Arsenico22/Sigmoid_Accelerator_IP-CORE/Presentazione.pdf

Dipartimento di Ingegneria Informatica, Modellistica, Elettronica e Sistemistica

Corso di Laurea Magistrale in Ingegneria Elettronica

Design e caratterizzazione di IP-Core su FPGA

per funzioni di attivazione in modelli di

Intelligenza Artificiale

ANNO ACCADEMICO 2025/2026

Relatrice:

Prof.ssa Stefania Perri

Candidato:

Danilo Antonio Tarantino
Matr. 247705

## Introduzione 1/16

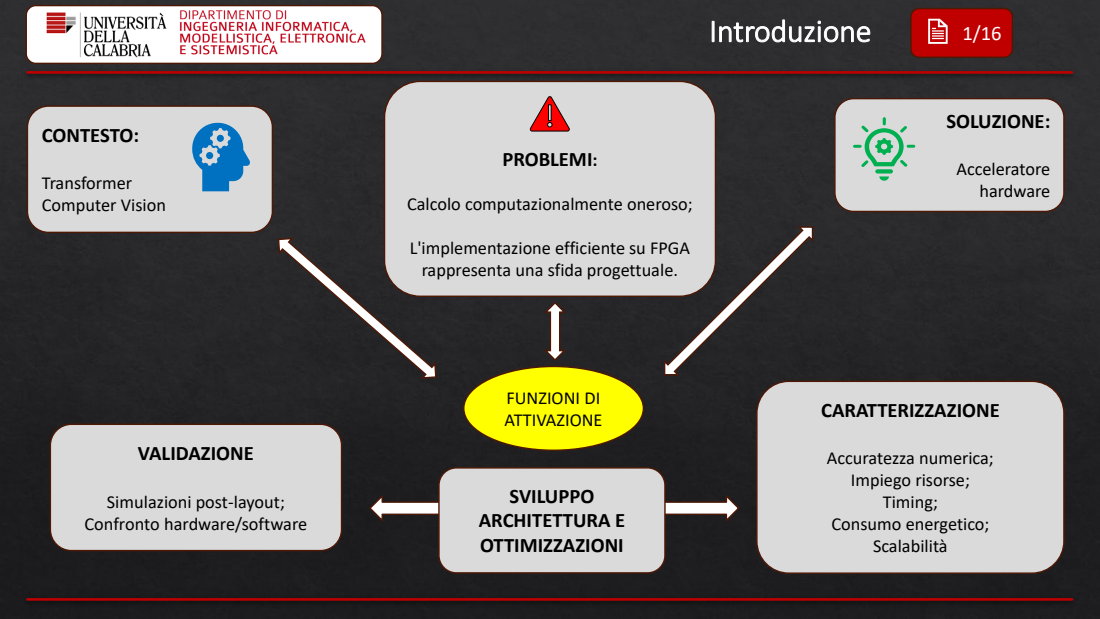
[picture p63: page 2]
SOLUZIONE:; Acceleratore hardware; FUNZIONI DI ATTIVAZIONE; CONTESTO:; Transformer Computer Vision; PROBLEMI:; SVILUPPO ARCHITETTURA E OTTIMIZZAZIONI; VALIDAZIONE; CARATTERIZZAZIONE; Accuratezza numerica; Impiego risorse; Timing; Consumo energetico; Scalabilità

Calcolo computazionalmente oneroso;

L'implementazione efficiente su FPGA
rappresenta una sfida progettuale.

Simulazioni post-layout;
Confronto hardware/software

## Contesto

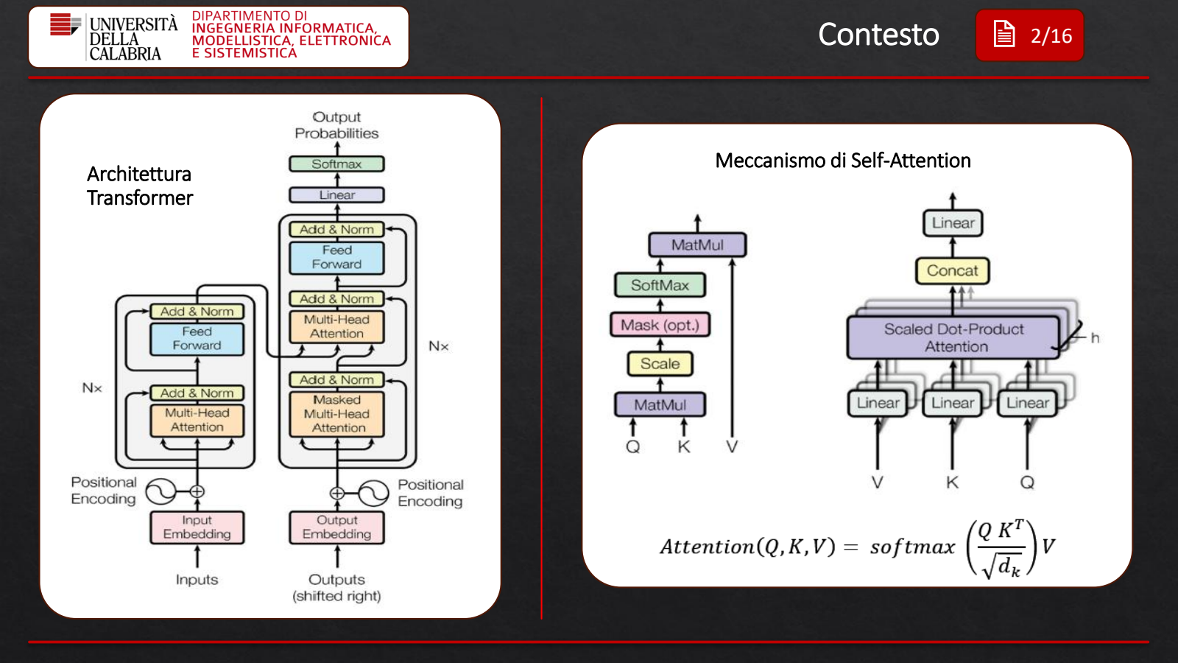
[picture p64: page 3]

2/16

Meccanismo di Self-Attention Architettura Transformer

## Funzioni di Attivazione 3/16

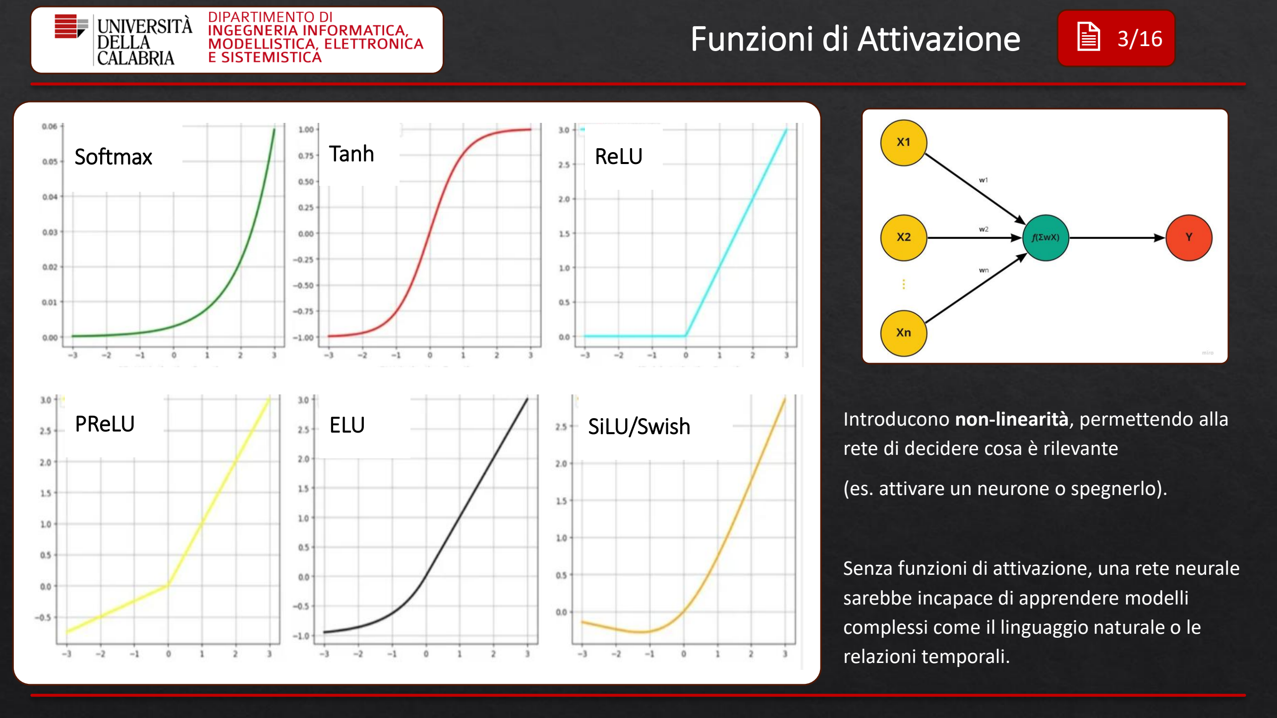
[picture p65: page 4]

Introducono non-linearità, permettendo alla rete di decidere cosa è rilevante

(es. attivare un neurone o spegnerlo).

Senza funzioni di attivazione, una rete neurale sarebbe incapace di apprendere modelli complessi come il linguaggio naturale o le relazioni temporali.

Softmax | Tanh | ReLU
PReLU | ELU | SiLU/Swish

## Caso studio: Funzione Sigmoide 4/16

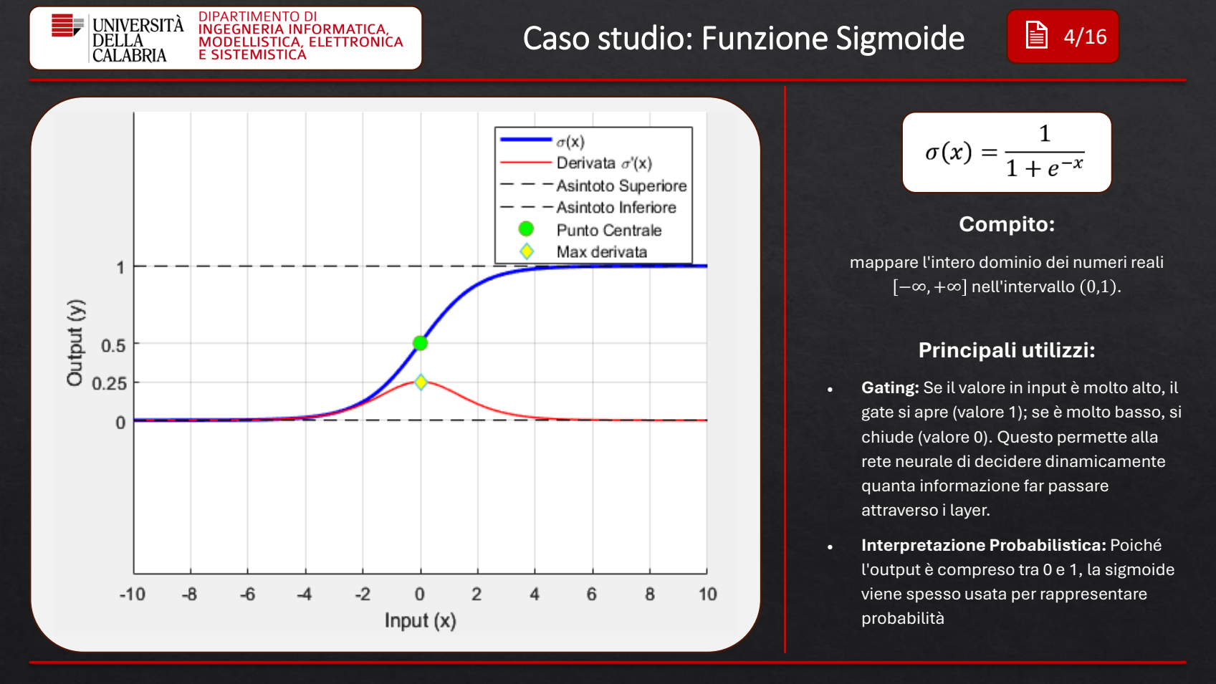
[picture p66: page 5]

### Compito:

mappare l'intero dominio dei numeri reali −∞, +∞ nell'intervallo 0,1 .

### Principali utilizzi:

- Gating: Se il valore in input è molto alto, il gate si apre (valore 1); se è molto basso, si chiude (valore 0). Questo permette alla rete neurale di decidere dinamicamente quanta informazione far passare attraverso i layer.
- Interpretazione Probabilistica: Poiché l'output è compreso tra 0 e 1, la sigmoide viene spesso usata per rappresentare probabilità

## Approccio utilizzato 5/16

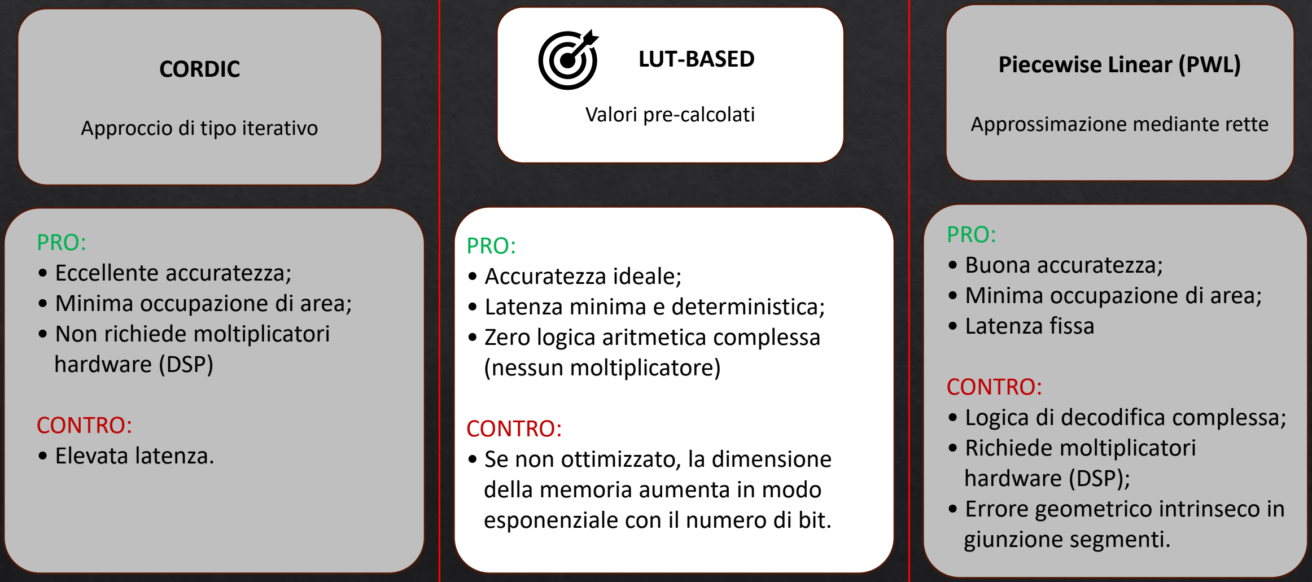
[picture p67: figure]
Piecewise Linear (PWL); Approssimazione mediante rette; LUT-BASED; Valori pre-calcolati; CORDIC; Approccio di tipo iterativo; PRO: • Eccellente accuratezza; • Minima occupazione di area; • Non richiede moltiplicatori hardware (DSP); CONTRO: • Elevata latenza.; PRO: • Accuratezza ideale; • Latenza minima e deterministica; • Zero logica aritmetica complessa (nessun moltiplicatore); CONTRO: • Se non ottimizzato, la dimensione della memoria aumenta in modo esponenziale con il numero di bit.; PRO: • Buona accuratezza; • Minima occupazione di area; • Latenza fissa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

6/16

## Flusso di lavoro

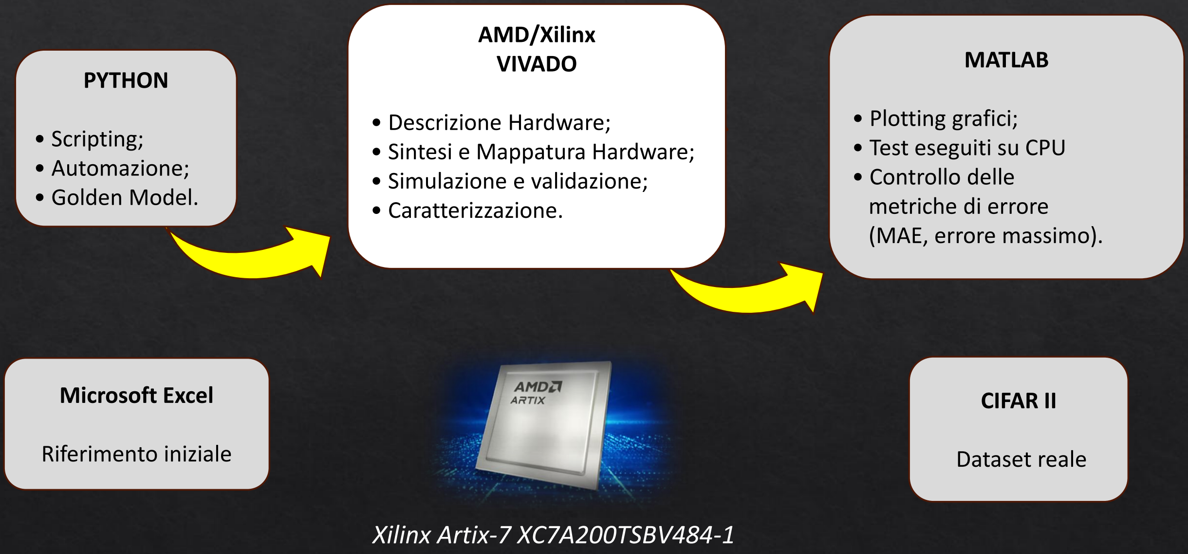
[picture p68: figure]
Xilinx Artix-7 XC7A200TSBV484-1; AMD/Xilinx VIVADO; • Descrizione Hardware; • Sintesi e Mappatura Hardware; • Simulazione e validazione; • Caratterizzazione.; MATLAB; • Plotting grafici; • Test eseguiti su CPU • Controllo delle metriche di errore (MAE, errore massimo).; PYTHON; • Scripting; • Automazione; • Golden Model.; Microsoft Excel; Riferimento iniziale; CIFAR II; Dataset reale

Baseline (V1) | Intermedia (V2) | Avanzata (V3) Architetture

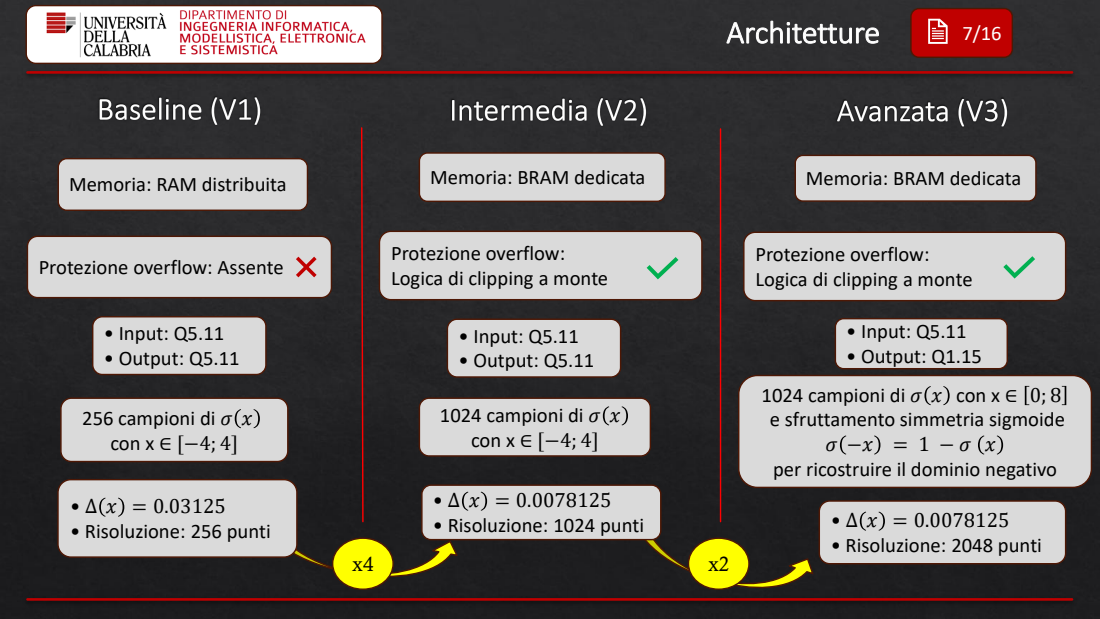
[picture p69: page 8]
256 campioni di σ x con x ∈ [−4; 4]; 1024 campioni di σ x con x ∈ [−4; 4]; 1024 campioni di σ x con x ∈; • Input: Q5.11 • Output: Q5.11; • Input: Q5.11 • Output: Q1.15; Memoria: RAM distribuita; Memoria: BRAM dedicata; • Δ x = 0.03125 • Risoluzione: 256 punti; • Risoluzione: 1024 punti; • Risoluzione: 2048 punti

Protezione overflow:
Logica di clipping a monte

Protezione overflow: Assente

e sfruttamento simmetria sigmoide
per ricostruire il dominio negativo

## Test e validazione

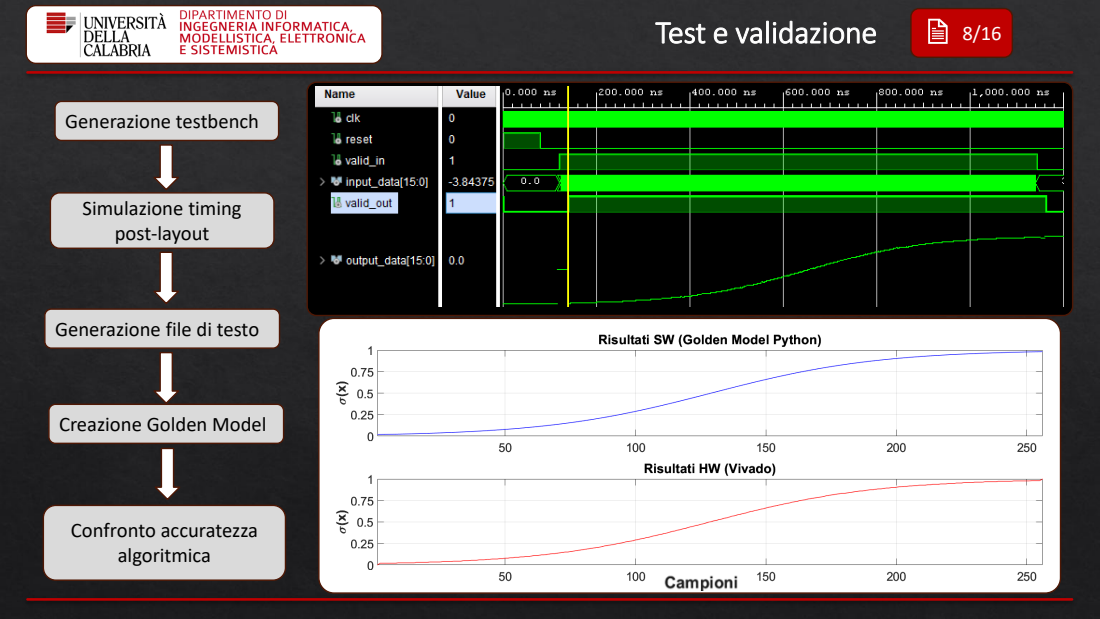
[picture p70: page 9]
Generazione testbench; Simulazione timing post-layout; Confronto accuratezza algoritmica

Generazione file di testo

Creazione Golden Model

## Confronto hardware vs software

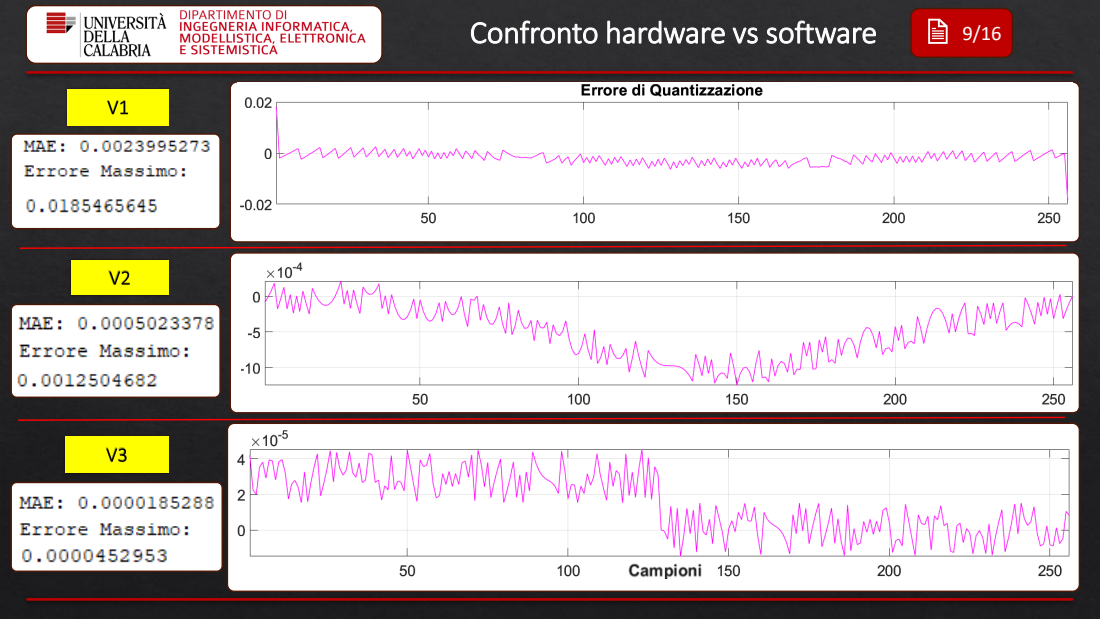
[picture p71: page 10]

## Report di utilizzo risorse

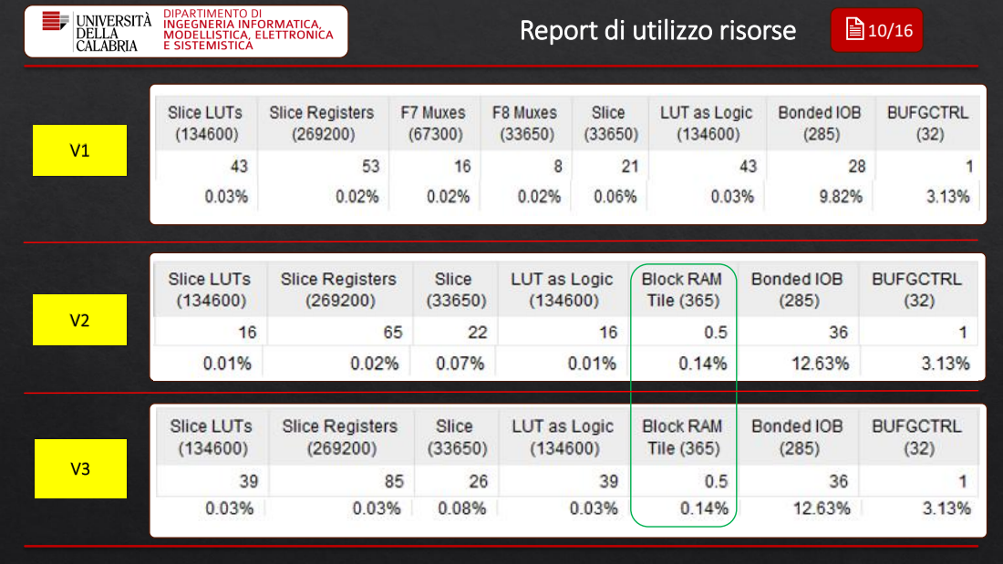
[picture p72: page 11]

## Report di timing

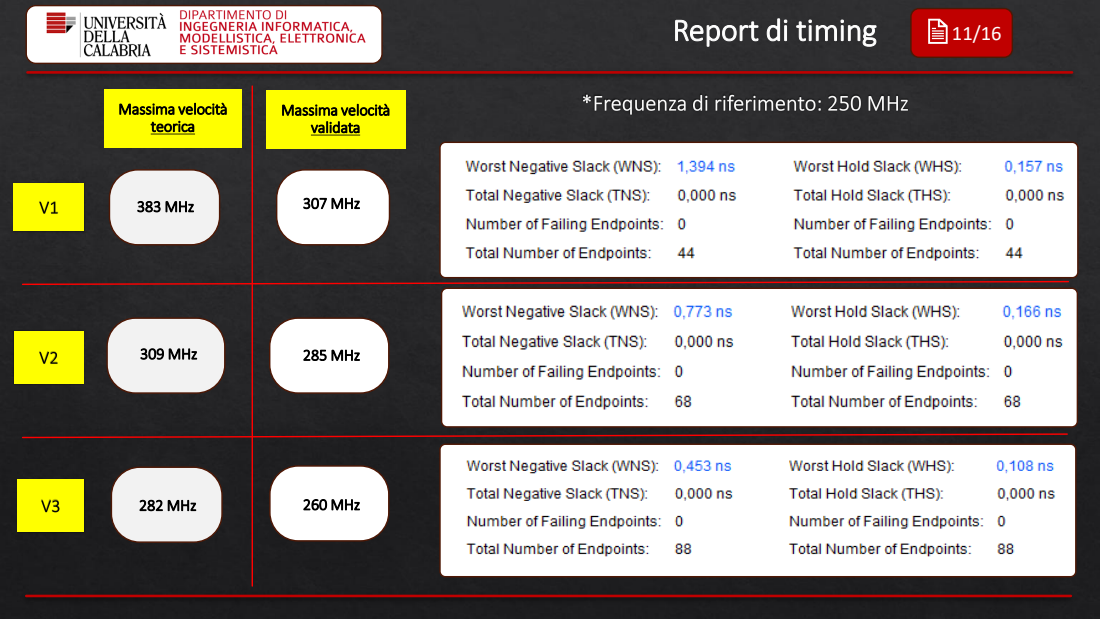
[picture p73: page 12]
Massima velocità teorica; 285 MHz; Massima velocità validata; 307 MHz; 260 MHz; 383 MHz; 309 MHz; 282 MHz

*Frequenza di riferimento: 250 MHz

## Report di potenza 12/16

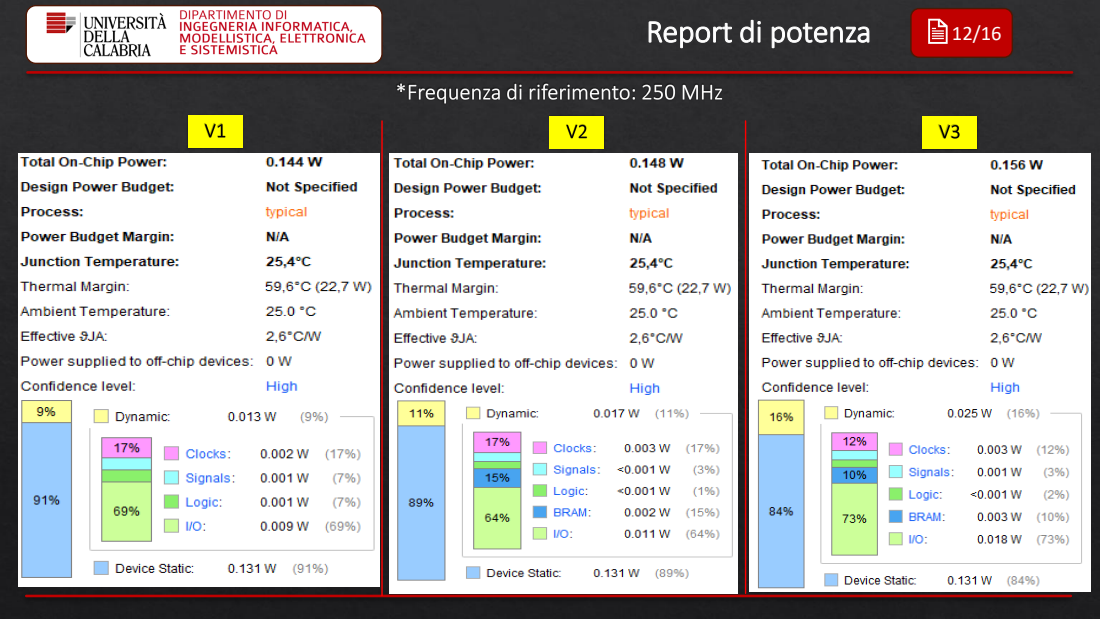
[picture p74: page 13]

*Frequenza di riferimento: 250 MHz

## Parallelismo 13/16

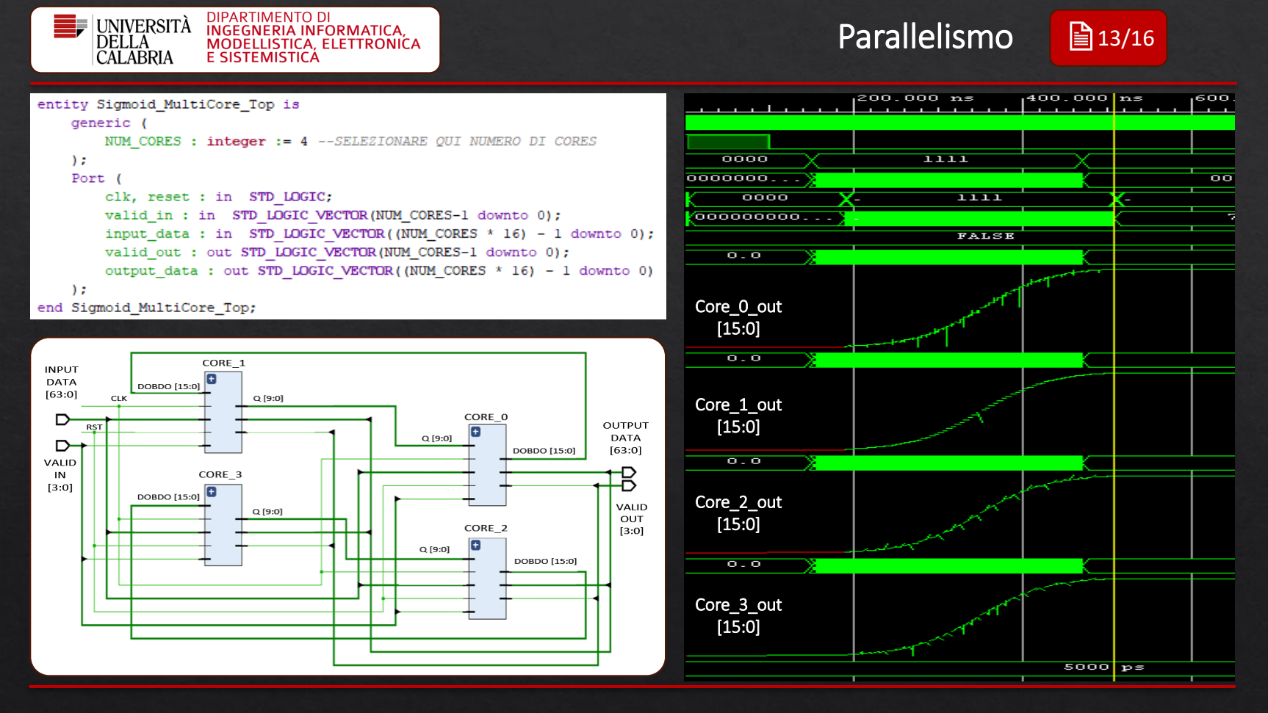
[picture p75: page 14]

Core_0_out
[15:0]

Core_1_out
[15:0]

Core_2_out
[15:0]

Core_3_out
[15:0]

## Scalabilità (Analisi OOC) 14/16

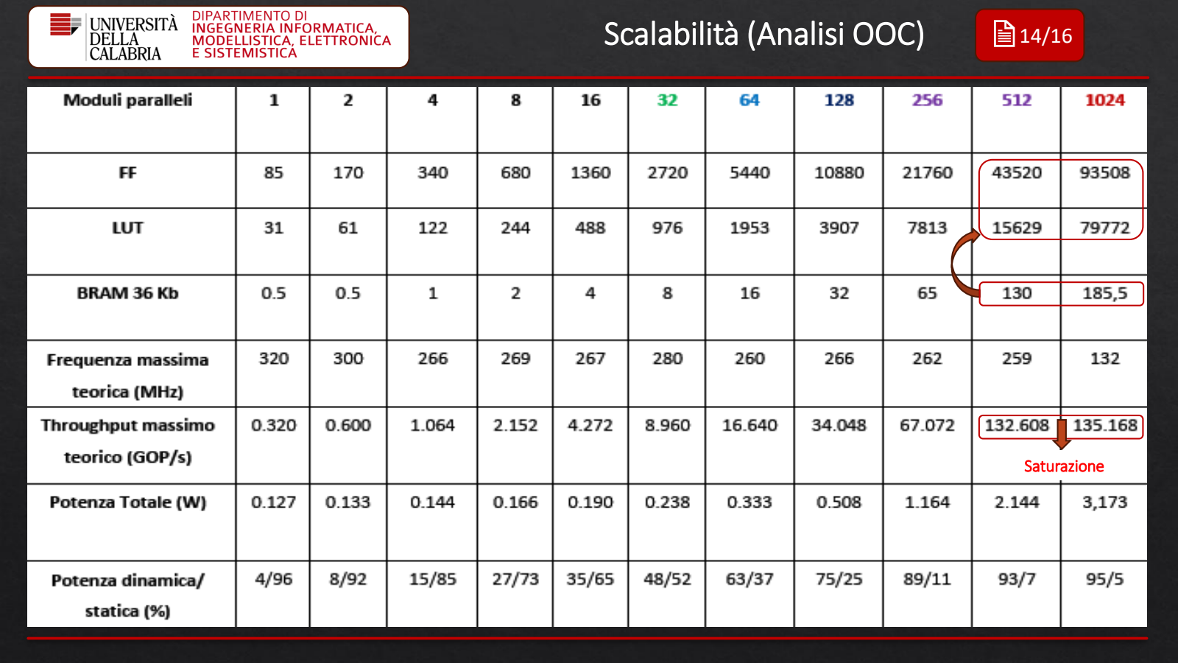
[picture p76: page 15]

Saturazione

## FPGA vs CPU 15/16

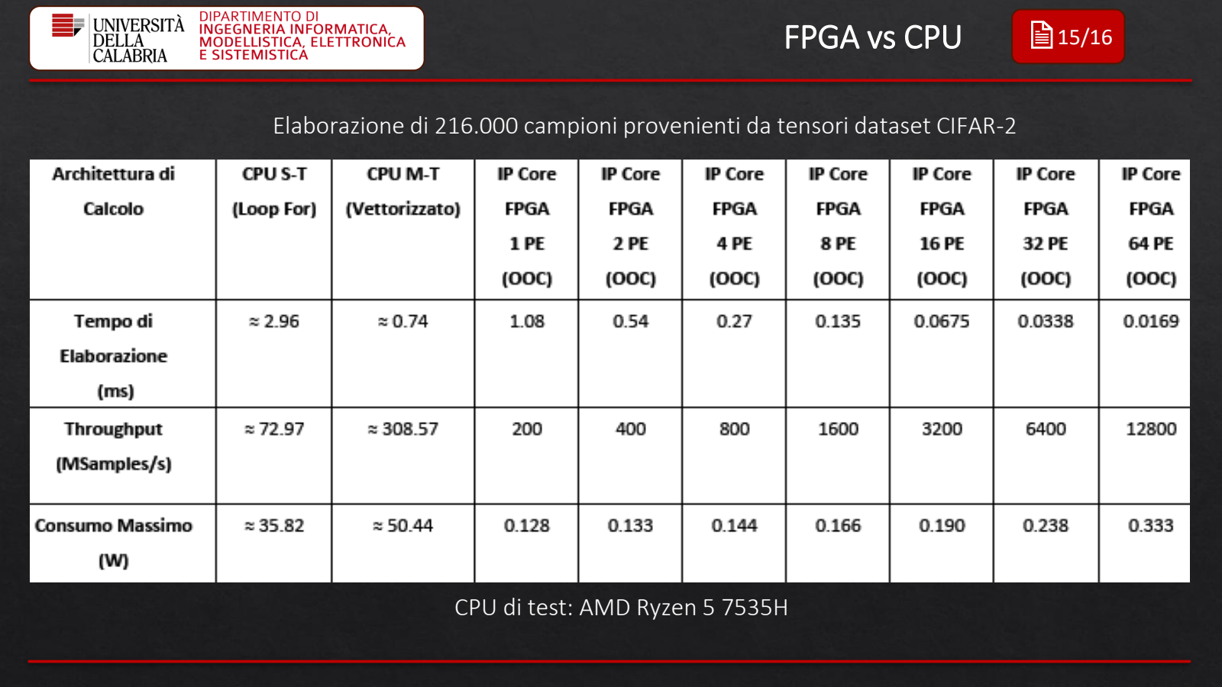
[picture p77: page 16]

CPU di test: AMD Ryzen 5 7535H

Elaborazione di 216.000 campioni provenienti da tensori dataset CIFAR-2

## Conclusioni 16/16

## IP Core FPGA

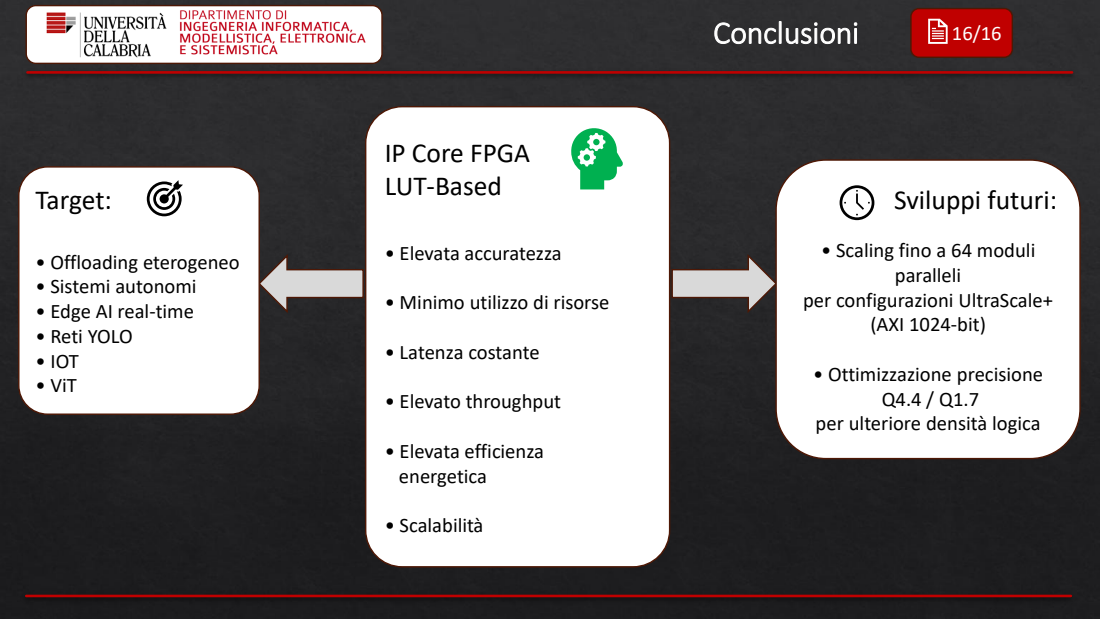
[picture p78: page 17]
Sviluppi futuri:; paralleli; (AXI 1024-bit); • Ottimizzazione precisione Q4.4 / Q1.7; LUT-Based; • Elevata accuratezza; • Latenza costante; • Elevato throughput; • Elevata efficienza energetica; • Scalabilità; Target:

• Scaling fino a 64 moduli

• Offloading eterogeneo
• Sistemi autonomi
• Edge AI real-time
• Reti YOLO
• IOT
• ViT

• Minimo utilizzo di risorse

per configurazioni UltraScale+

per ulteriore densità logica

# Hidden Slides

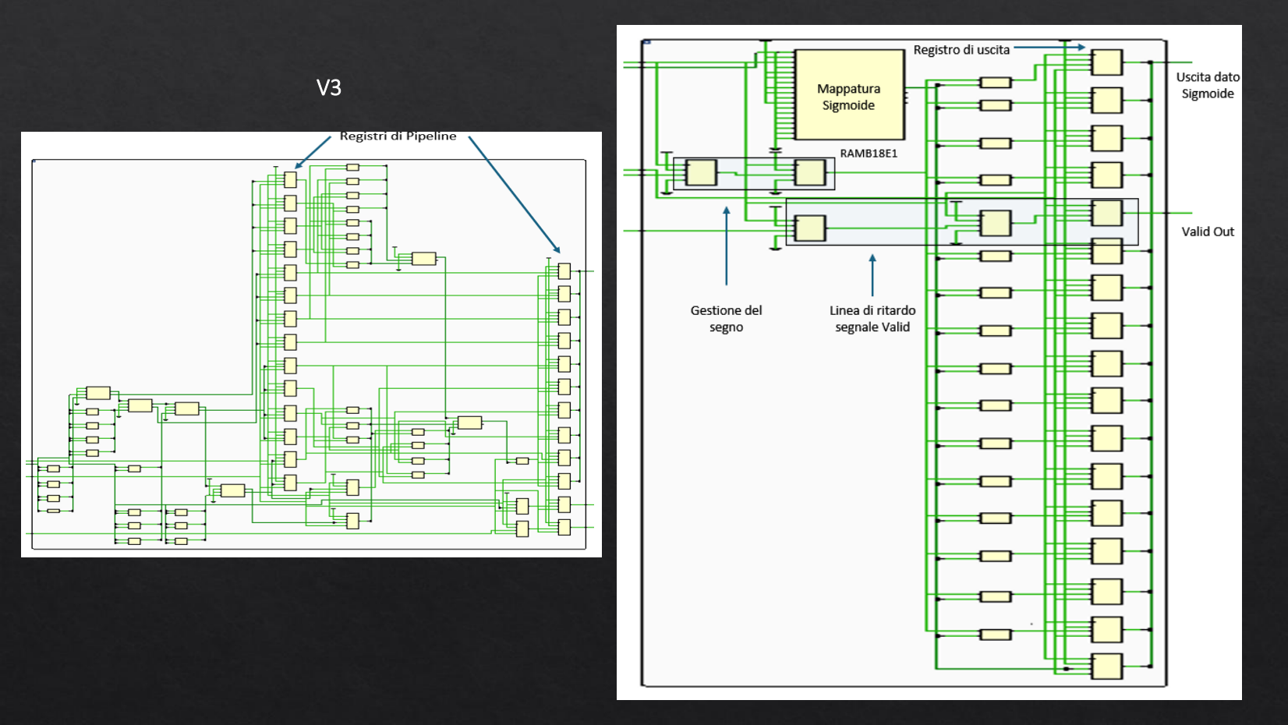
[picture p79: page 19]

V3

## Pipeline a 5 stadi

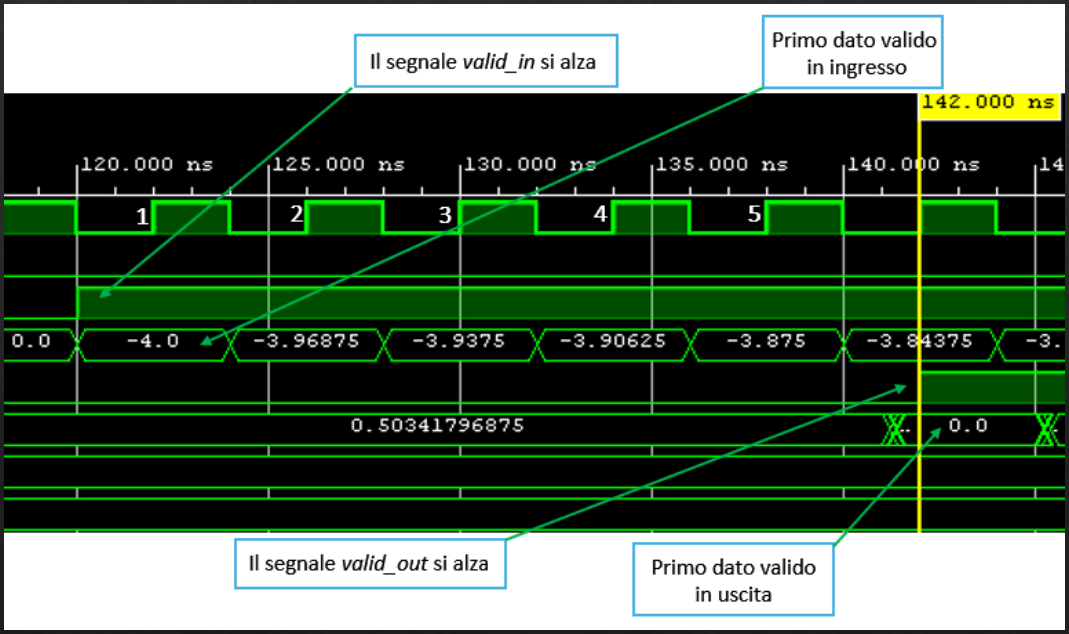
[picture p80: figure]
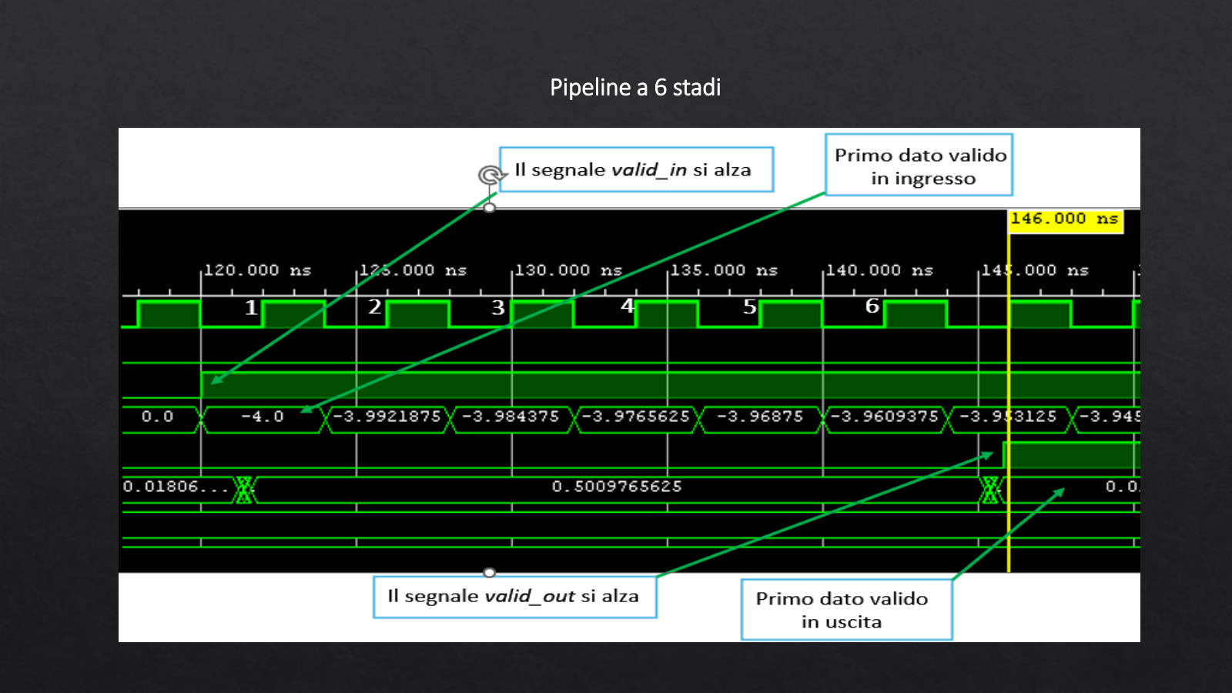
[picture p81: page 21]

Pipeline a 6 stadi

Pipeline a 7 stadi

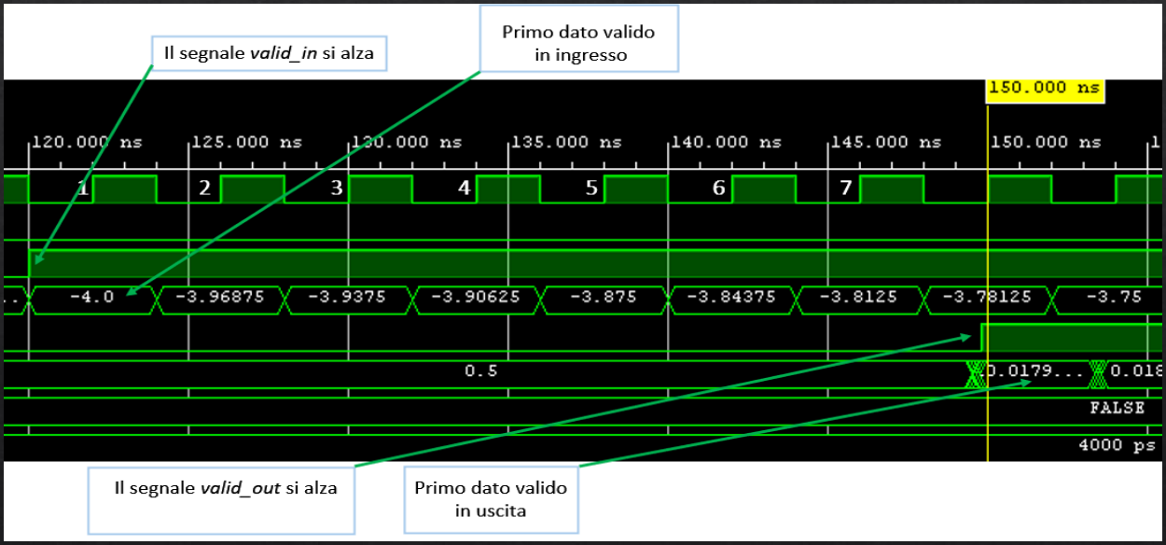
[picture p82: figure]

## Dettaglio Parallelismo

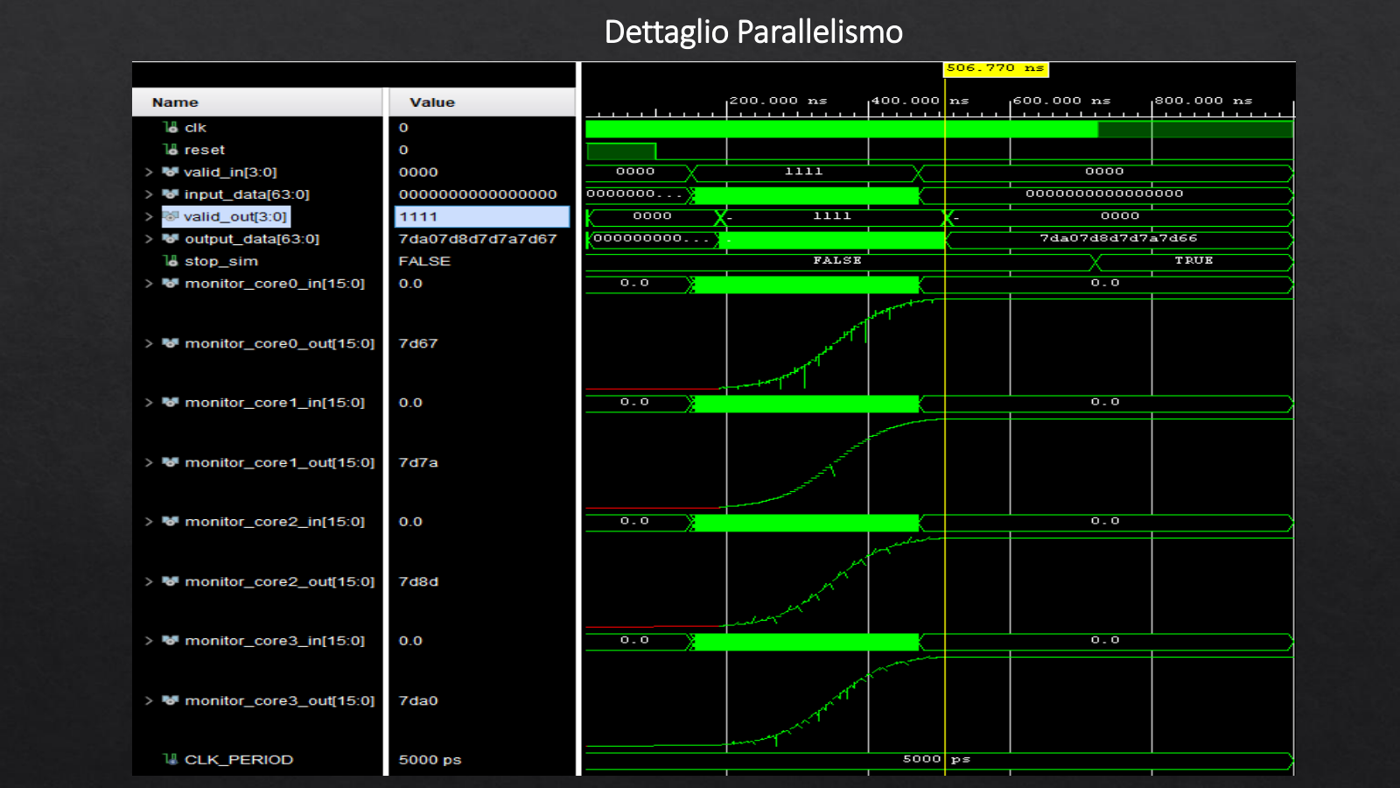
[picture p83: page 23]

## Dettaglio Parallelismo

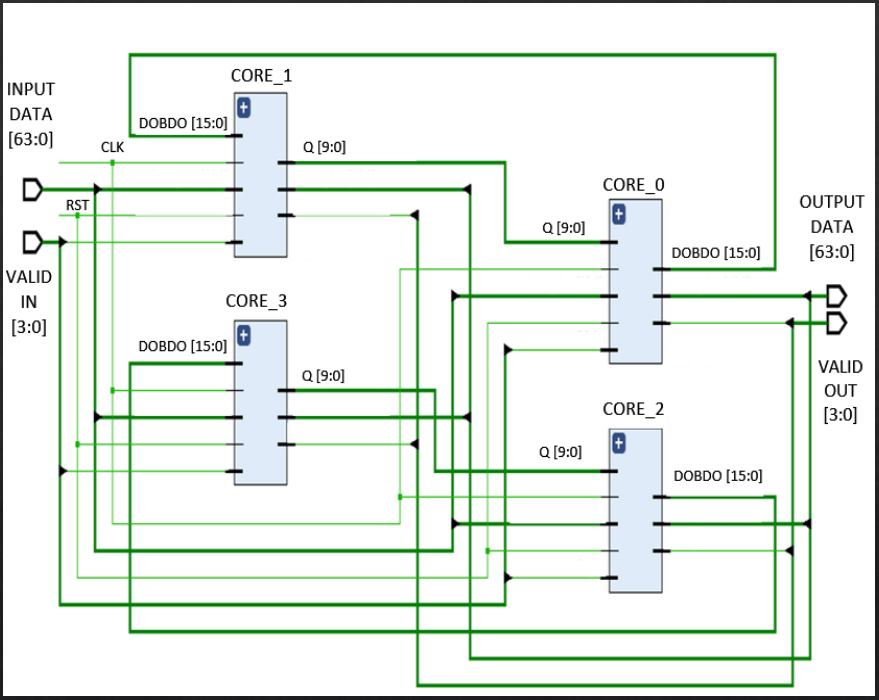
[picture p84: figure]
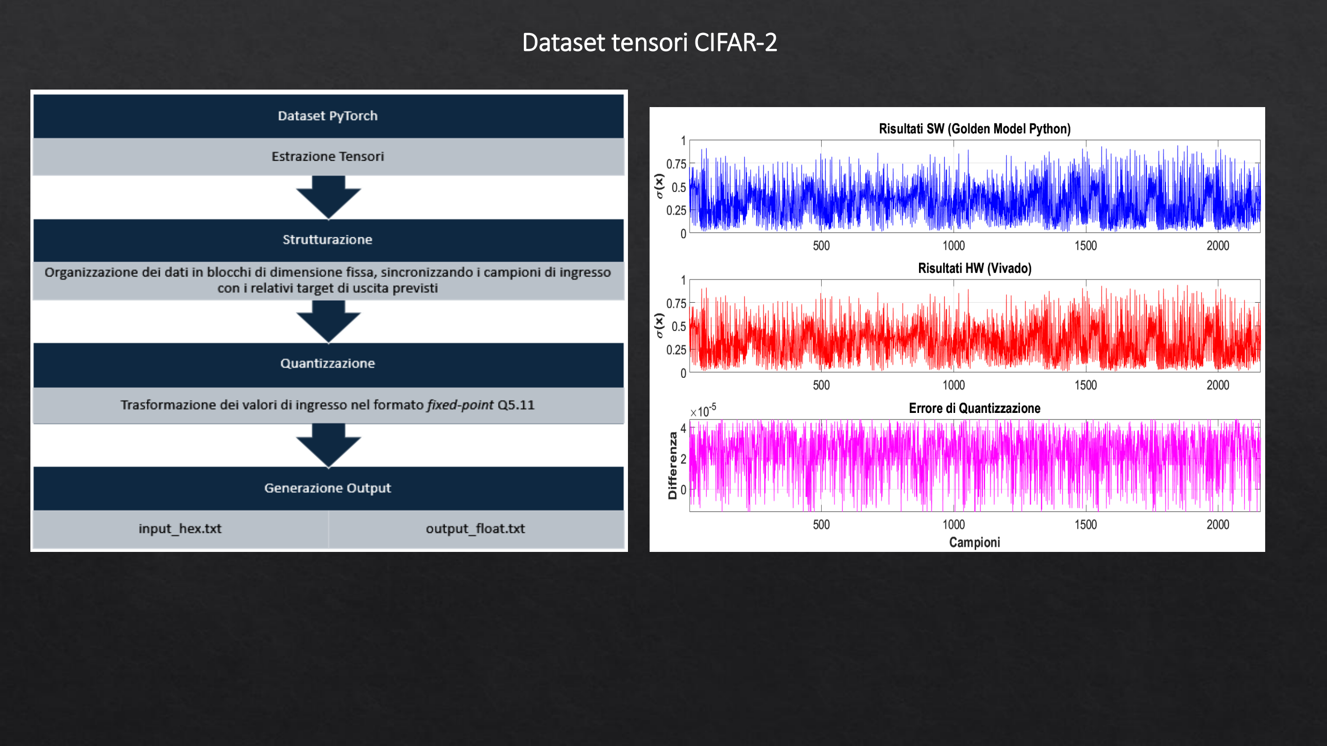
[picture p85: page 25]

Dataset tensori CIFAR-2

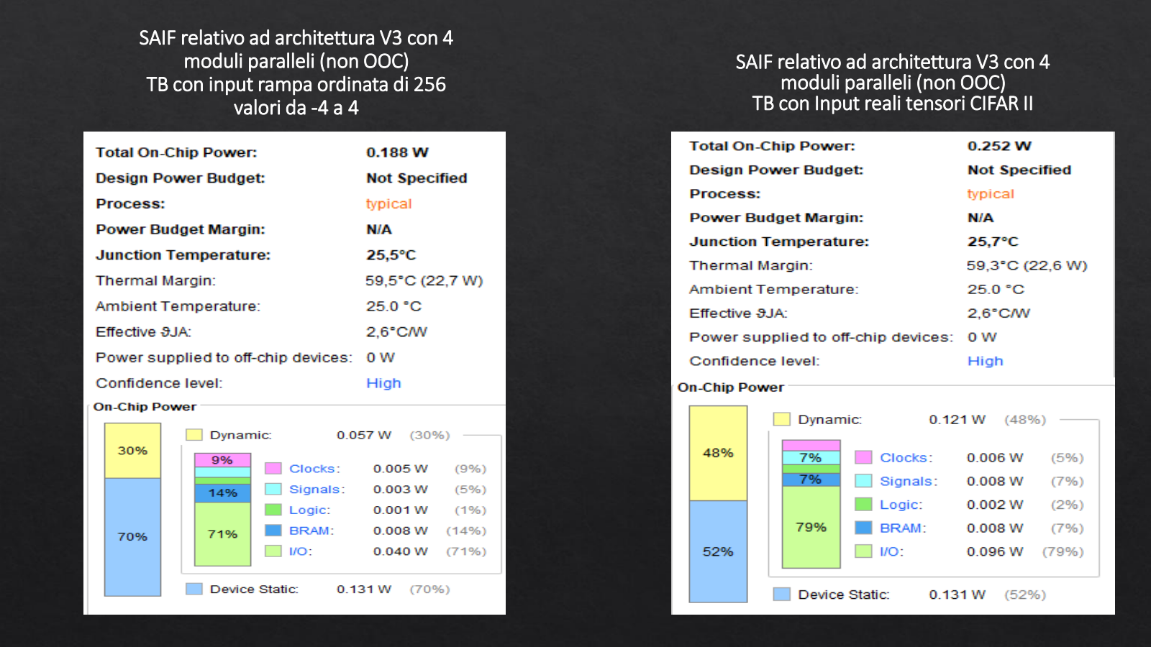
[picture p86: page 26]

SAIF relativo ad architettura V3 con 4 moduli paralleli (non OOC)
TB con input rampa ordinata di 256 valori da

-4 a 4

SAIF relativo ad architettura V3 con 4 moduli paralleli (non OOC)
TB con Input reali tensori CIFAR II

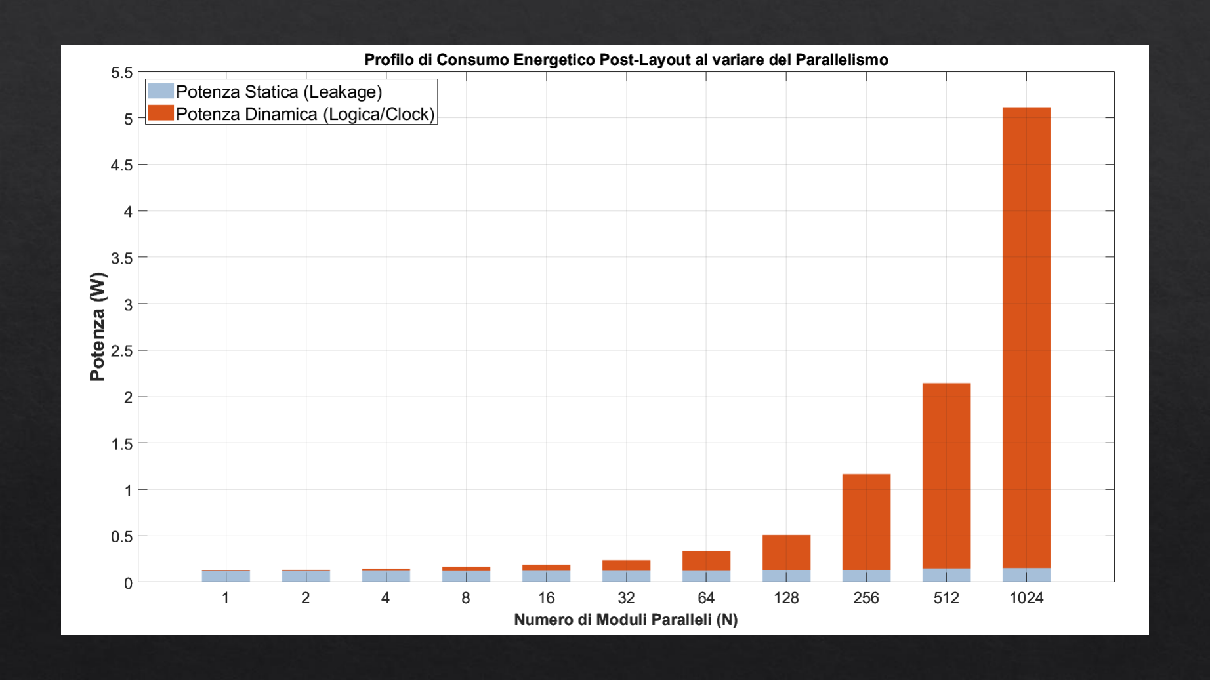
[picture p87: page 27]

## Dettaglio

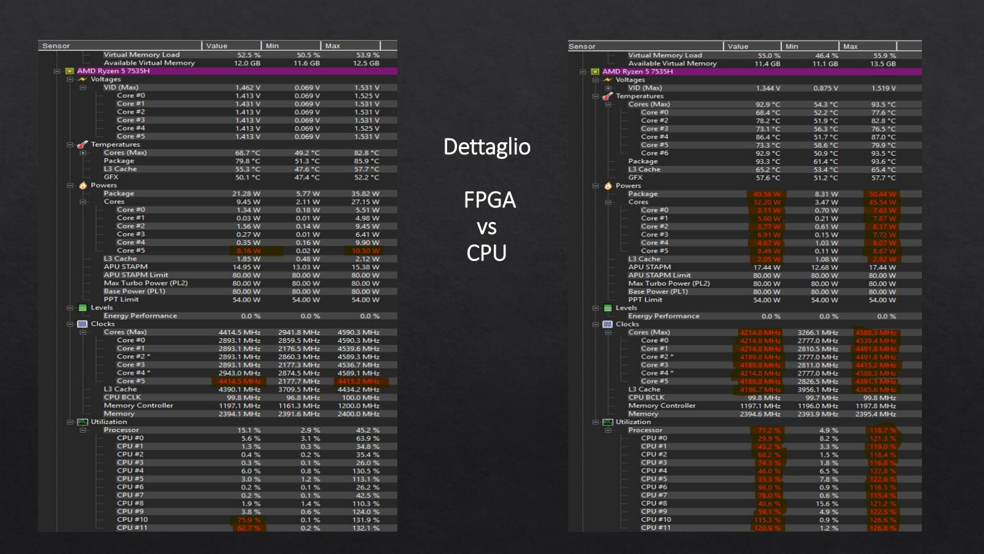
[picture p88: page 28]

## FPGA

vs

## CPU
