Arsenico22/Sigmoid_Accelerator_IP-CORE/vhd_files/Baseline/TOP_Design.vhd

library IEEE;
use IEEE.STD_LOGIC_1164.ALL;
use IEEE.NUMERIC_STD.ALL;

entity TOP_Design is
    Port ( 
         clk, reset, valid_in : in  STD_LOGIC;
         input_data : in  STD_LOGIC_VECTOR (15 downto 0);
         valid_out : out STD_LOGIC;
         output_data : out STD_LOGIC_VECTOR (15 downto 0)
         );
end TOP_Design;

architecture Structural of TOP_Design is

    component Pre_Processing
        Port ( 
             clk, reset, valid_in : in  STD_LOGIC;
             data_in : in  STD_LOGIC_VECTOR (15 downto 0);
             valid_out : out STD_LOGIC;
             addr_out : out UNSIGNED (7 downto 0)
             );
    end component;

    component Sigmoid_LUT
        Port ( 
             clk, reset, valid_in : in  STD_LOGIC;
             addr_in : in  UNSIGNED (7 downto 0);
             valid_out : out STD_LOGIC;
             data_out : out STD_LOGIC_VECTOR (15 downto 0)
             );
    end component;
    
    -- Segnali Pipeline
    signal internal_addr : UNSIGNED (7 downto 0);
    signal reg_valid_in, internal_valid, reg_valid_out : STD_LOGIC;
    signal reg_input_data, reg_output_data : STD_LOGIC_VECTOR(15 downto 0);
    
begin
    
    -- I stadio pipeline: input buffering
    process(clk)
    begin
        if rising_edge(clk) then
            if reset = '1' then
                reg_input_data <= (others => '0');
                reg_valid_in   <= '0';
            else
                reg_input_data <= input_data;
                reg_valid_in <= valid_in;
            end if;
        end if;
    end process;


    -- II stadio pipeline: logica di pre-processing
    PP: Pre_Processing
        port map (clk => clk, reset => reset, valid_in => reg_valid_in, data_in => reg_input_data, valid_out => internal_valid, addr_out => internal_addr);
        
    -- III, IV stadio pipeline: accesso alla memoria e uscita
    MEM: Sigmoid_LUT
        port map (clk => clk,reset => reset, valid_in => internal_valid, addr_in => internal_addr, valid_out => reg_valid_out, data_out => reg_output_data);


    -- V stadio pipeline: output buffering
    process(clk)
         begin
            if rising_edge(clk) then
                if reset = '1' then
                    output_data <= (others => '0');
                    valid_out <= '0';
                else
                 output_data <= reg_output_data;
                 valid_out <= reg_valid_out;
                end if;
             end if;
        end process;

end Structural;
