Arsenico22/Sigmoid_Accelerator_IP-CORE/vhd_files/Baseline/Sigmoid_Values.vhd

library IEEE;
use IEEE.STD_LOGIC_1164.ALL;


package Sigmoid_Values is
    
    type lut_type is array (0 to 255) of std_logic_vector(15 downto 0);
    
    constant SIGMOID_TABLE : lut_type := 
    
   ( x"0000", x"002a", x"002a", x"002a", x"002a", x"002a", x"002a", x"002a",
    x"0034", x"0034", x"0034", x"0034", x"0034", x"0034", x"0034", x"003e",
    x"003e", x"003e", x"003e", x"003e", x"0048", x"0048", x"0048", x"0048",
    x"0048", x"0052", x"0052", x"0052", x"0052", x"005c", x"005c", x"005c",
    x"005c", x"0067", x"0067", x"0067", x"0071", x"0071", x"0071", x"007b",
    x"007b", x"007b", x"0085", x"0085", x"008f", x"008f", x"008f", x"0099",
    x"0099", x"00a3", x"00a3", x"00ae", x"00ae", x"00b8", x"00b8", x"00c2",
    x"00c2", x"00cb", x"00cb", x"00d5", x"00df", x"00df", x"00e8", x"00f2",
    x"00f2", x"00fc", x"0105", x"010f", x"010f", x"0119", x"0123", x"012c",
    x"0135", x"0135", x"013f", x"0149", x"0153", x"015d", x"0166", x"0170",
    x"0179", x"0183", x"018d", x"0196", x"019f", x"01a8", x"01b2", x"01c5",
    x"01cf", x"01d9", x"01e3", x"01ec", x"01fe", x"0207", x"0211", x"0224",
    x"022d", x"0237", x"0241", x"0255", x"025e", x"0270", x"0278", x"028a",
    x"0293", x"02a5", x"02b7", x"02c0", x"02d3", x"02dc", x"02ef", x"02f9",
    x"030c", x"031f", x"0329", x"033d", x"0347", x"035b", x"0365", x"0379",
    x"038d", x"0397", x"03ab", x"03b5", x"03ca", x"03d4", x"03e8", x"03fd",
    x"0407", x"041c", x"0426", x"043a", x"0445", x"0459", x"0463", x"0477",
    x"048b", x"0495", x"04a9", x"04b3", x"04c7", x"04d1", x"04e5", x"04f8",
    x"0502", x"0515", x"051e", x"0531", x"053a", x"054d", x"055f", x"0568",
    x"057a", x"0582", x"0594", x"059c", x"05b0", x"05ba", x"05c4", x"05d8",
    x"05e1", x"05eb", x"05fd", x"0607", x"0610", x"0622", x"062b", x"0635",
    x"063f", x"0649", x"0652", x"065c", x"066e", x"0678", x"0682", x"068c",
    x"0695", x"069f", x"06a8", x"06a8", x"06b2", x"06bc", x"06c5", x"06cf",
    x"06d8", x"06e2", x"06e2", x"06ec", x"06f6", x"0700", x"0700", x"070a",
    x"0713", x"0713", x"071d", x"0727", x"0727", x"0731", x"0731", x"073b",
    x"0745", x"0745", x"074f", x"074f", x"0759", x"0759", x"0763", x"0763",
    x"076c", x"076c", x"076c", x"0776", x"0776", x"0780", x"0780", x"0780",
    x"078a", x"078a", x"078a", x"0794", x"0794", x"0794", x"079f", x"079f",
    x"079f", x"07a9", x"07a9", x"07a9", x"07a9", x"07b3", x"07b3", x"07b3",
    x"07b3", x"07bd", x"07bd", x"07bd", x"07bd", x"07bd", x"07c7", x"07c7",
    x"07c7", x"07c7", x"07c7", x"07c7", x"07d1", x"07d1", x"07d1", x"07d1",
    x"07d1", x"07d1", x"07d1", x"07d9", x"07d9", x"07d9", x"07d9", x"0800"  );
    
    
end package Sigmoid_Values;
